rayshobby/opensprinkler-beagle/hardware/osbo_v10_diagram.jpg

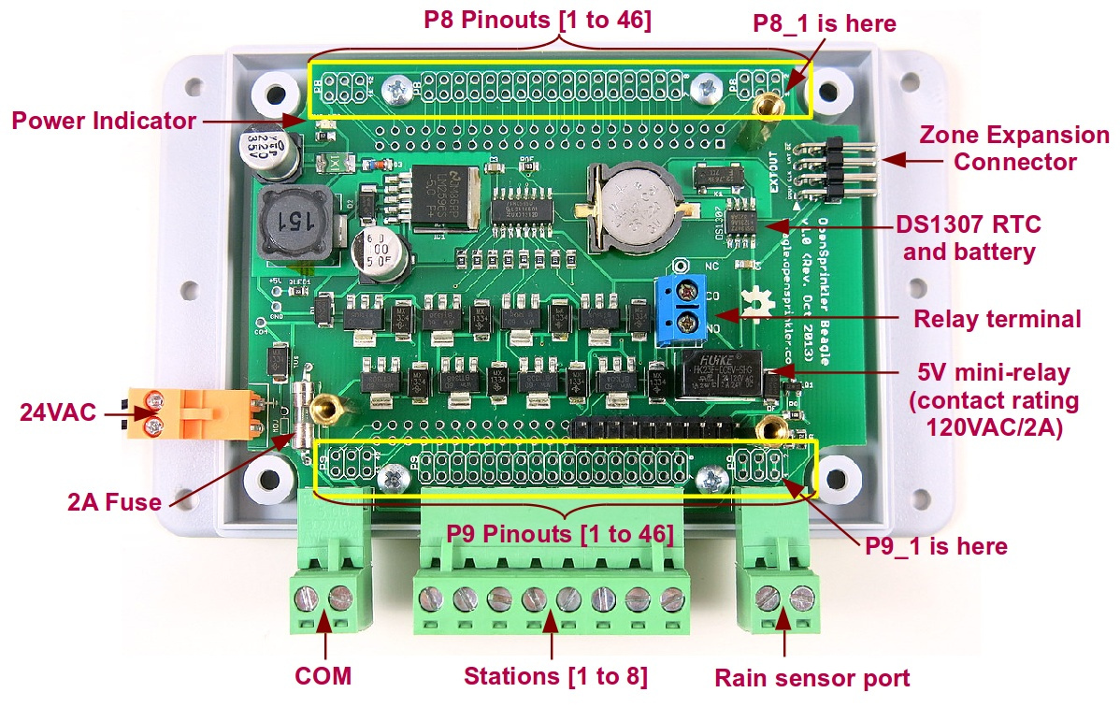
hardware/osbo_v10_diagram.jpg
