rayshobby/opensprinkler-beagle/README.md

opensprinkler-beagle
====================

OpenSprinkler Beagle (http://beagle.opensprinkler.com)
