rayshobby/opensprinkler-beagle/hardware/README.txt

OpenSprinkler Beagle (OSBo) Eagle Design Files
==========================================
Note: requires Eagle CAD v6.0 or above

Part lists of all versions can be found at:
http://xxx

Release Notes
=============
Version 1.1
---------------------
- Changed to use OpenSprinkler injection-molded enclosure
- Changed relay to HK4100F-5V

Initial Release v1.0
---------------------
- LM2596S-5.0 switching regulator.
- DS1307 RTC with CR1220 backup battery.
- Shift register, BT1308W triac solenoid driver.
- SMBJ48CA bidirectional TVS.
- 5V mini-relay (contact rating 120VAC/2A).
- 2A solder-on fuse.
