rayshobby/opensprinkler-beagle/hardware/osbo_v10_sch.png

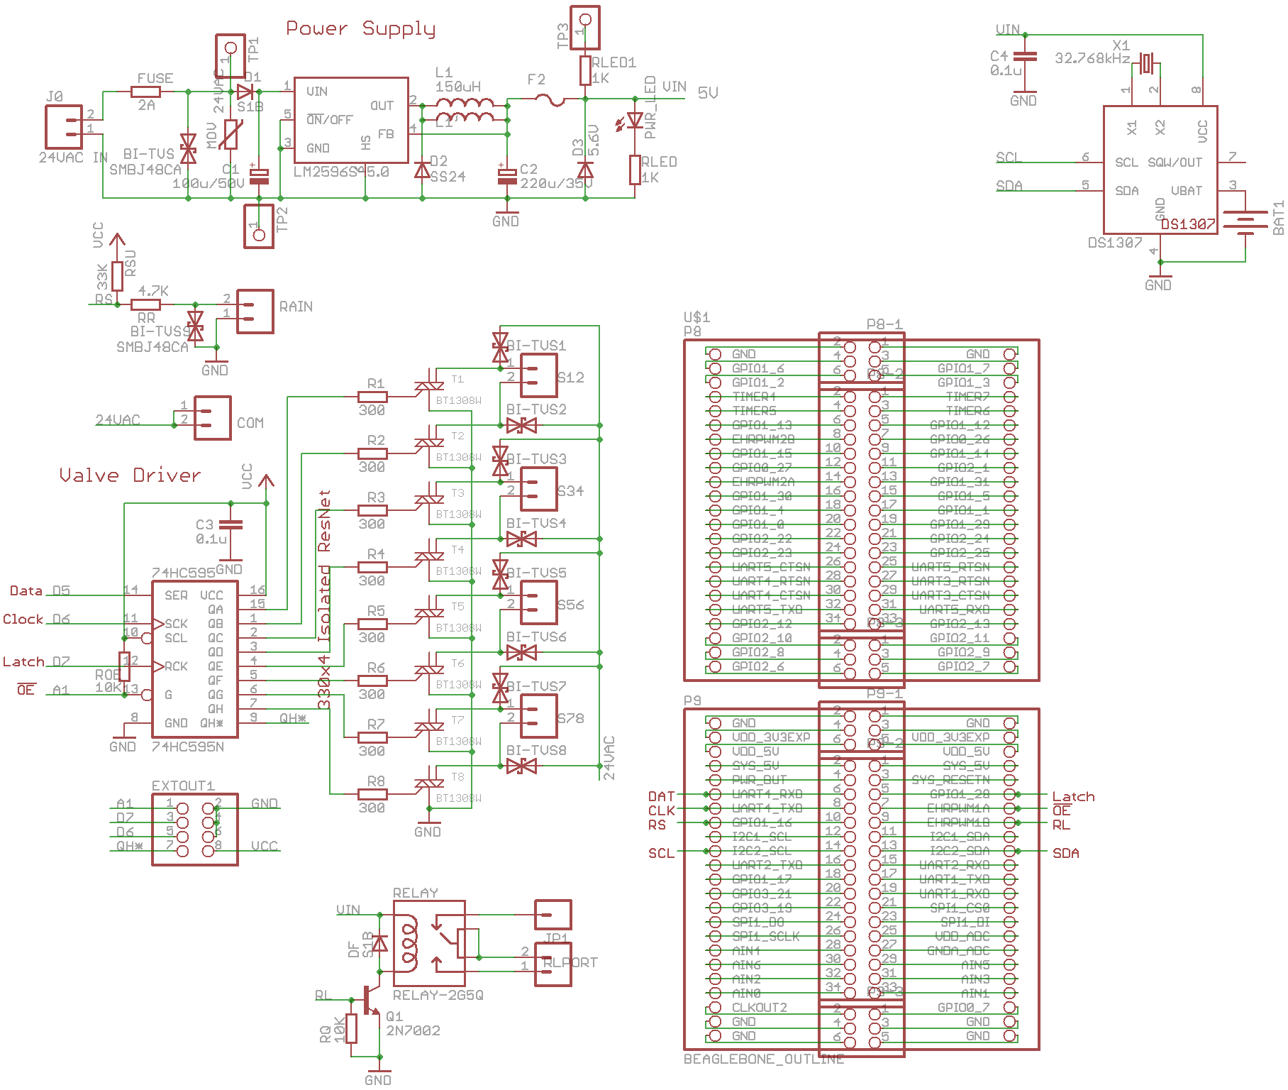
hardware/osbo_v10_sch.png
