rayshobby/opensprinkler-beagle/hardware/osbo_v11_sch.png

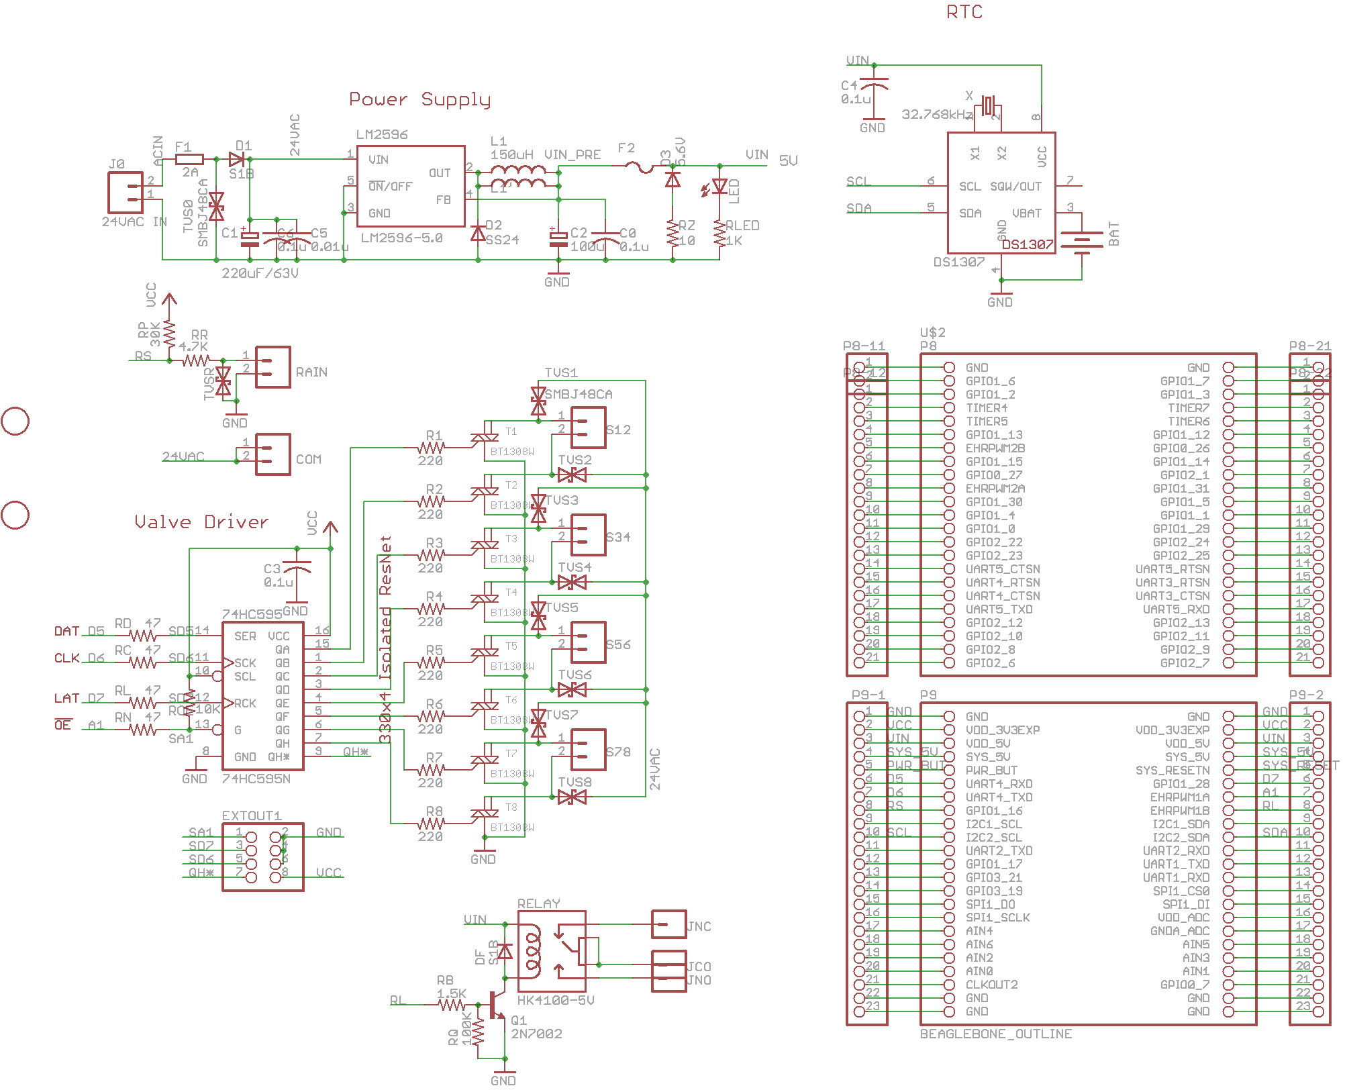
hardware/osbo_v11_sch.png
