rayshobby/opensprinkler-beagle/hardware/osbo_v11.brd

## EAGLE design hardware/osbo_v11.brd (2015-04-25)

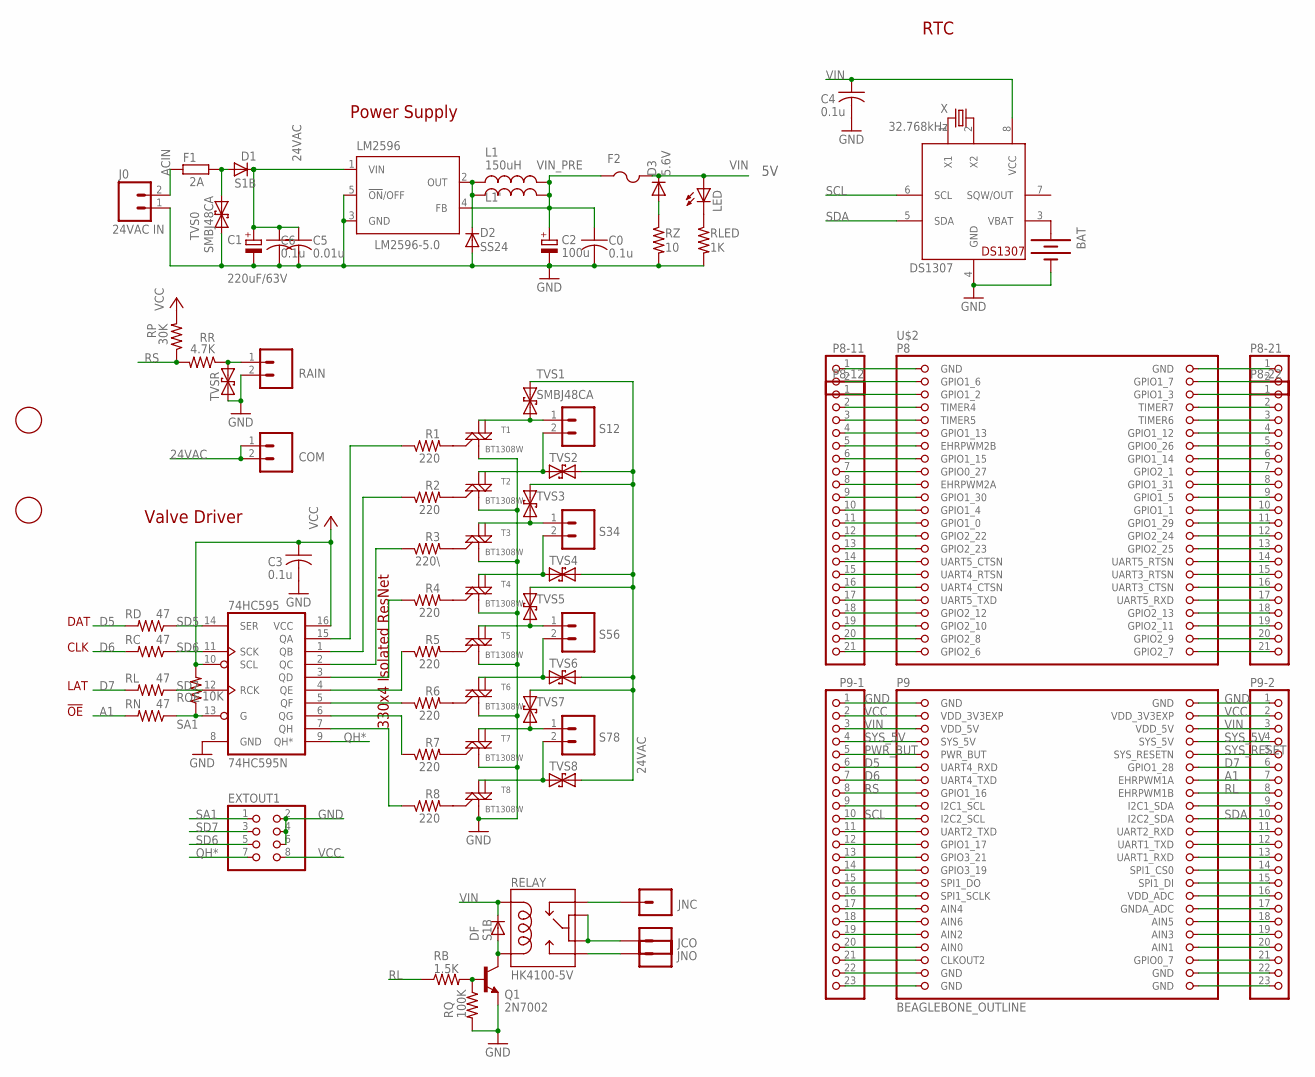
[picture p5: schematic osbo_v11.sch]

Parts:
74HC595: 74HC595N; SO16
BAT: BATTERYBATTERY_12MM_SMT; BATTCON_12MM_SMT
C0, C3, C4, C6: 0.1u; C0805K
C1: 220uF/63V; E5-10.5-1
C2: 100u; E3,5-8
C5: 0.01u; C0805K
COM: M025MM-X; SCREWTERMINAL-5MM-2-X
D1: S1B; DO-214AC
D2: SS24; SMB
D3: 5.6V; MINIMELF
DF: S1B; DO-214AC
DS1307: DS1307; SO08
EXTOUT1: PINHD-2X4/90; 2X04/90
F1: 2A; 0411V
F2: PTCFUSE-1812; 1812
J0: 24VAC IN; SCREWTERMINAL-4MM-2-X
JCO: M01PTH; 1X01
JNC: M01PTH; 1X01
JNO: M01PTH; 1X01
L1: 150uH; CDRH125
L1': 150uH; 0207/7
LED: LEDCHIPLED_0805; CHIPLED_0805
LM2596: LM2596-5.0; TO263-5
P8-11, P8-21: PINHD-1X2; 1X02
P8-12, P8-22: PINHD-1X21; 1X21
P9-1, P9-2: PINHD-1X23; 1X23
Q1: 2N7002; SOT23-3
R1, R2, R4, R5, R6, R7, R8: 220; R0805
R3: 220\; R0805
RAIN: M025MM-X; SCREWTERMINAL-5MM-2-X
RB: 1.5K; R0805
RC: 47; R0805
RD: 47; R0805
RELAY: HK4100-5V; RELAY-HK4100F
RL: 47; R0805
RLED: 1K; R0805
RN: 47; R0805
ROE: 10K; R0805
RP: 30K; R0805
RQ: 100K; R0805
RR: 4.7K; R0805
RZ: 10; R0805
S12, S34, S56, S78: M025MM-X; SCREWTERMINAL-5MM-2-X
T1, T2, T3, T4, T5, T6, T7, T8: BT1308W; SOT223
TVS0, TVS1: SMBJ48CA; SMB
TVS2, TVS3, TVS4, TVS5, TVS6, TVS7, TVS8: TVSSMB; SMB
TVSR: TVSSMB; SMB
U$1, U$3: FIDUCIAL; FIDUCIAL_1MM
U$2: BEAGLEBONE_OUTLINE; BEAGLEBONE_SHIELD
X: 32.768kHz; TC38H

Connections:
24VAC: COM.1, COM.2, D1.A, F1.2, TVS0.C, TVS1.C, TVS2.C, TVS3.C, TVS4.C, TVS5.C, TVS6.C, TVS7.C, TVS8.C
A1: P9-2.7, RN.2, U$2.60 (EHRPWM1A)
ACIN: F1.1, J0.2
CO: JCO.1, RELAY.5, RELAY.6
D5: P9-1.6, RD.2, U$2.57 (UART4_RXD)
D6: P9-1.7, RC.2, U$2.59 (UART4_TXD)
D7: P9-2.6, RL.2, U$2.58 (GPIO1_28)
GND: 74HC595.8 (GND), BAT.P$1 (-), C0.2, C1.-, C2.-, C3.2, C4.2, C5.2, C6.2, D2.A, DS1307.4 (GND), EXTOUT1.2, EXTOUT1.4, EXTOUT1.6, J0.1, LM2596.3 (GND), LM2596.5 (!ON!/OFF), P8-11.1, P8-21.1, P9-1.1, P9-2.1, Q1.2 (E), RAIN.2, RLED.2, RQ.2, RZ.2, T1.1 (M1), T2.1 (M1), T3.1 (M1), T4.1 (M1), T5.1 (M1), T6.1 (M1), T7.1 (M1), T8.1 (M1), TVS0.A, TVSR.A, U$2.1 (GND), U$2.2 (GND), U$2.47 (GND), U$2.48 (GND)
unnamed: LED.C, RLED.1
unnamed: C1.+, C5.1, C6.1, D1.C, LM2596.1 (VIN)
unnamed: R1.2, T1.3 (G)
unnamed: 74HC595.5 (QF), R6.1
unnamed: 74HC595.6 (QG), R7.1
unnamed: D3.A, RZ.1
unnamed: 74HC595.7 (QH), R8.1
unnamed: D2.C, L1.1, L1'.1, LM2596.2 (OUT)
unnamed: DS1307.1 (X1), X.2
unnamed: 74HC595.4 (QE), R5.1
unnamed: 74HC595.3 (QD), R4.1
unnamed: 74HC595.2 (QC), R3.1
unnamed: 74HC595.1 (QB), R2.1
unnamed: 74HC595.15 (QA), R1.1
unnamed: R2.2, T2.3 (G)
unnamed: S12.1, T1.2 (M2), TVS1.A
unnamed: S12.2, T2.2 (M2), TVS2.A
unnamed: S34.1, T3.2 (M2), TVS3.A
unnamed: R3.2, T3.3 (G)
unnamed: S34.2, T4.2 (M2), TVS4.A
unnamed: R4.2, T4.3 (G)
unnamed: S56.1, T5.2 (M2), TVS5.A
unnamed: S56.2, T6.2 (M2), TVS6.A
unnamed: S78.1, T7.2 (M2), TVS7.A
unnamed: S78.2, T8.2 (M2), TVS8.A
unnamed: R5.2, T5.3 (G)
unnamed: R6.2, T6.3 (G)
unnamed: R7.2, T7.3 (G)
unnamed: R8.2, T8.3 (G)
unnamed: DS1307.2 (X2), X.1
unnamed: RAIN.1, RR.1, TVSR.C
unnamed: Q1.1 (B), RB.2, RQ.1
unnamed: P8-11.2, U$2.3 (GPIO1_6)
unnamed: P8-12.1, U$2.5 (GPIO1_2)
unnamed: BAT.P$2 (+), DS1307.3 (VBAT)
unnamed: P8-12.2, U$2.7 (TIMER4)
unnamed: P8-12.3, U$2.9 (TIMER5)
unnamed: P8-12.4, U$2.11 (GPIO1_13)
unnamed: P8-12.5, U$2.13 (EHRPWM2B)
unnamed: P8-12.6, U$2.15 (GPIO1_15)
unnamed: P8-12.7, U$2.17 (GPIO0_27)
unnamed: P8-12.8, U$2.19 (EHRPWM2A)
unnamed: P8-12.9, U$2.21 (GPIO1_30)
unnamed: P8-12.10, U$2.23 (GPIO1_4)
unnamed: P8-12.11, U$2.25 (GPIO1_0)
unnamed: P8-12.12, U$2.27 (GPIO2_22)
unnamed: P8-12.13, U$2.29 (GPIO2_23)
unnamed: P8-12.14, U$2.31 (UART5_CTSN)
unnamed: P8-12.15, U$2.33 (UART4_RTSN)
unnamed: P8-12.16, U$2.35 (UART4_CTSN)
unnamed: P8-12.17, U$2.37 (UART5_TXD)
unnamed: P8-12.18, U$2.39 (GPIO2_12)
unnamed: P8-12.19, U$2.41 (GPIO2_10)
unnamed: P8-12.20, U$2.43 (GPIO2_8)
unnamed: P8-12.21, U$2.45 (GPIO2_6)
unnamed: P8-21.2, U$2.4 (GPIO1_7)
unnamed: P8-22.1, U$2.6 (GPIO1_3)
unnamed: P8-22.2, U$2.8 (TIMER7)
unnamed: P8-22.3, U$2.10 (TIMER6)
unnamed: P8-22.4, U$2.12 (GPIO1_12)
unnamed: P8-22.5, U$2.14 (GPIO0_26)
unnamed: P8-22.6, U$2.16 (GPIO1_14)
unnamed: P8-22.7, U$2.18 (GPIO2_1)
unnamed: P8-22.8, U$2.20 (GPIO1_31)
unnamed: P8-22.9, U$2.22 (GPIO1_5)
unnamed: P8-22.10, U$2.24 (GPIO1_1)
unnamed: P8-22.11, U$2.26 (GPIO1_29)
unnamed: P8-22.12, U$2.28 (GPIO2_24)
unnamed: P8-22.13, U$2.30 (GPIO2_25)
unnamed: P8-22.14, U$2.32 (UART5_RTSN)
unnamed: P8-22.15, U$2.34 (UART3_RTSN)
unnamed: P8-22.16, U$2.36 (UART3_CTSN)
unnamed: P8-22.17, U$2.38 (UART5_RXD)
unnamed: P8-22.18, U$2.40 (GPIO2_13)
unnamed: DF.A, Q1.3 (C), RELAY.9
unnamed: P8-22.19, U$2.42 (GPIO2_11)
unnamed: P8-22.20, U$2.44 (GPIO2_9)
unnamed: P8-22.21, U$2.46 (GPIO2_7)
unnamed: P9-1.9, U$2.63 (I2C1_SCL)
unnamed: P9-1.11, U$2.67 (UART2_TXD)
unnamed: P9-1.12, U$2.69 (GPIO1_17)
unnamed: P9-1.13, U$2.71 (GPIO3_21)
unnamed: P9-1.14, U$2.73 (GPIO3_19)
unnamed: P9-1.15, U$2.75 (SPI1_DO)
unnamed: P9-1.16, U$2.77 (SPI1_SCLK)
unnamed: P9-1.17, U$2.79 (AIN4)
unnamed: P9-1.18, U$2.81 (AIN6)
unnamed: P9-1.19, U$2.83 (AIN2)
unnamed: P9-1.20, U$2.85 (AIN0)
unnamed: P9-1.21, U$2.87 (CLKOUT2)
unnamed: P9-1.22, U$2.89 (GND)
unnamed: P9-1.23, U$2.91 (GND)
unnamed: P9-2.9, U$2.64 (I2C1_SDA)
unnamed: P9-2.11, U$2.68 (UART2_RXD)
unnamed: P9-2.12, U$2.70 (UART1_TXD)
unnamed: P9-2.13, U$2.72 (UART1_RXD)
unnamed: P9-2.14, U$2.74 (SPI1_CS0)
unnamed: P9-2.15, U$2.76 (SPI1_DI)
unnamed: P9-2.16, U$2.78 (VDD_ADC)
unnamed: P9-2.17, U$2.80 (GNDA_ADC)
unnamed: P9-2.18, U$2.82 (AIN5)
unnamed: P9-2.19, U$2.84 (AIN3)
unnamed: P9-2.20, U$2.86 (AIN1)
unnamed: P9-2.21, U$2.88 (GPIO0_7)
unnamed: P9-2.22, U$2.90 (GND)
unnamed: P9-2.23, U$2.92 (GND)
NC: JNC.1, RELAY.1
NO: JNO.1, RELAY.10
PWR_BUT: P9-1.5, U$2.55 (PWR_BUT)
QH*: 74HC595.9 (QH*), EXTOUT1.7
RL: P9-2.8, RB.1, U$2.62 (EHRPWM1B)
RS: P9-1.8, RP.1, RR.2, U$2.61 (GPIO1_16)
SA1: 74HC595.13 (G), EXTOUT1.1, RN.1, ROE.1
SCL: DS1307.6 (SCL), P9-1.10, U$2.65 (I2C2_SCL)
SD5: 74HC595.14 (SER), RD.1
SD6: 74HC595.11 (SCK), EXTOUT1.5, RC.1
SD7: 74HC595.12 (RCK), EXTOUT1.3, RL.1
SDA: DS1307.5 (SDA), P9-2.10, U$2.66 (I2C2_SDA)
SYS_5V: P9-1.4, P9-2.4, U$2.53 (SYS_5V), U$2.54 (SYS_5V)
SYS_RESET: P9-2.5, U$2.56 (SYS_RESETN)
VCC: 74HC595.10 (SCL), 74HC595.16 (VCC), C3.1, EXTOUT1.8, P9-1.2, P9-2.2, ROE.2, RP.2, U$2.49 (VDD_3V3EXP), U$2.50 (VDD_3V3EXP)
VIN: C4.1, D3.C, DF.C, DS1307.8 (VCC), F2.2, LED.A, P9-1.3, P9-2.3, RELAY.2, U$2.51 (VDD_5V), U$2.52 (VDD_5V)
VIN_PRE: C0.1, C2.+, F2.1, L1.2, L1'.2, LM2596.4 (FB)

Notes on the sheet:
Power Supply
Valve Driver
DAT
CLK
LAT
330x4 Isolated ResNet
!OE
RTC

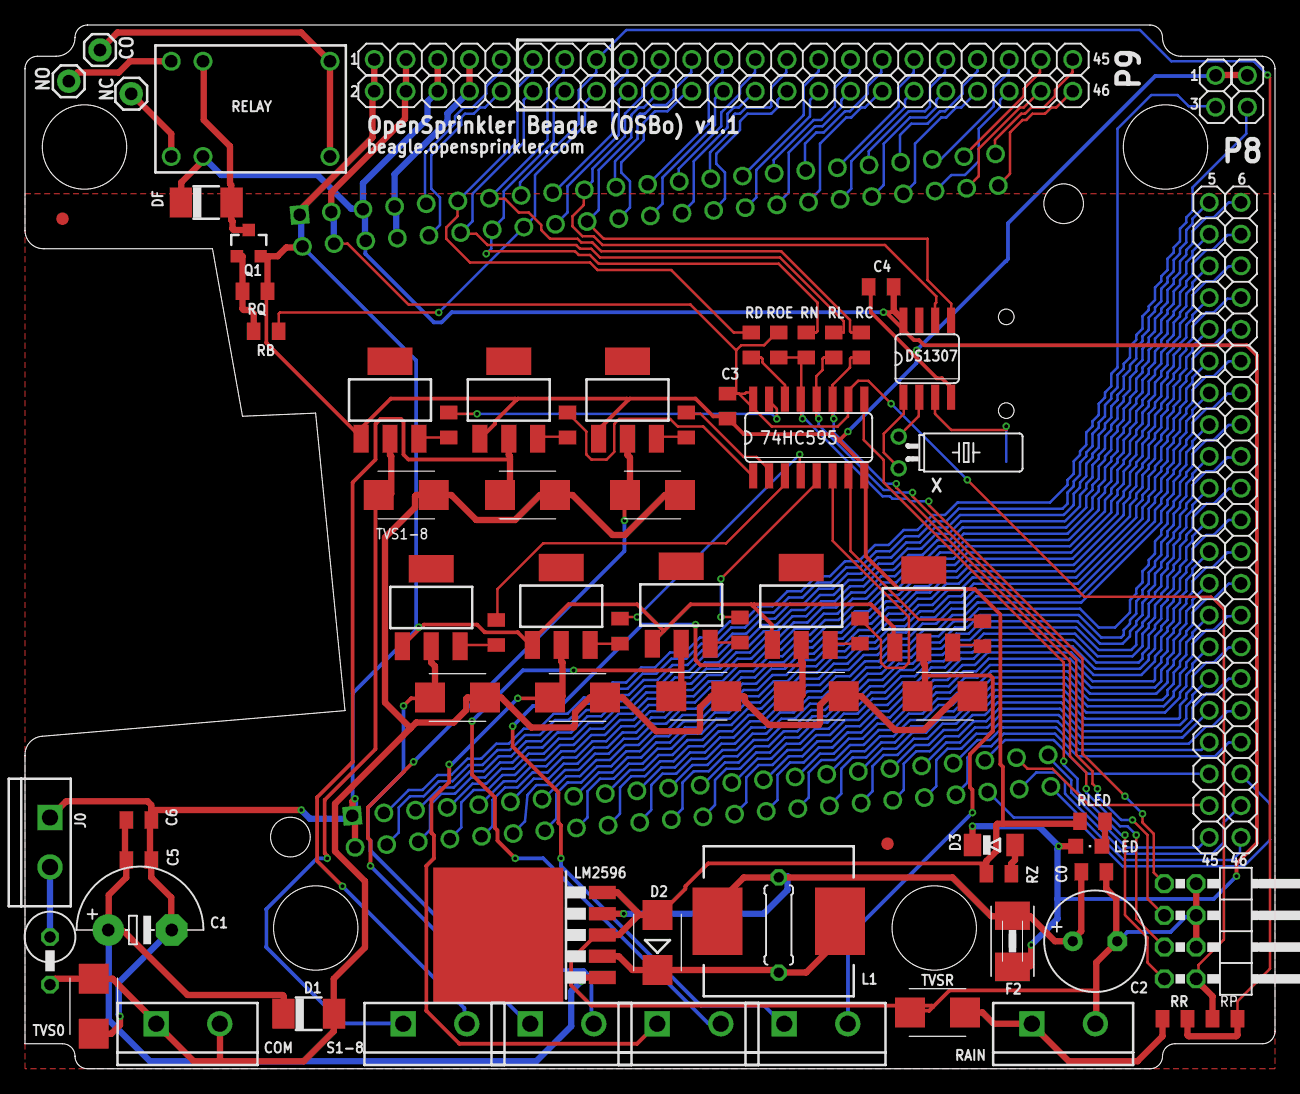
[picture p6: board osbo_v11.brd from above]

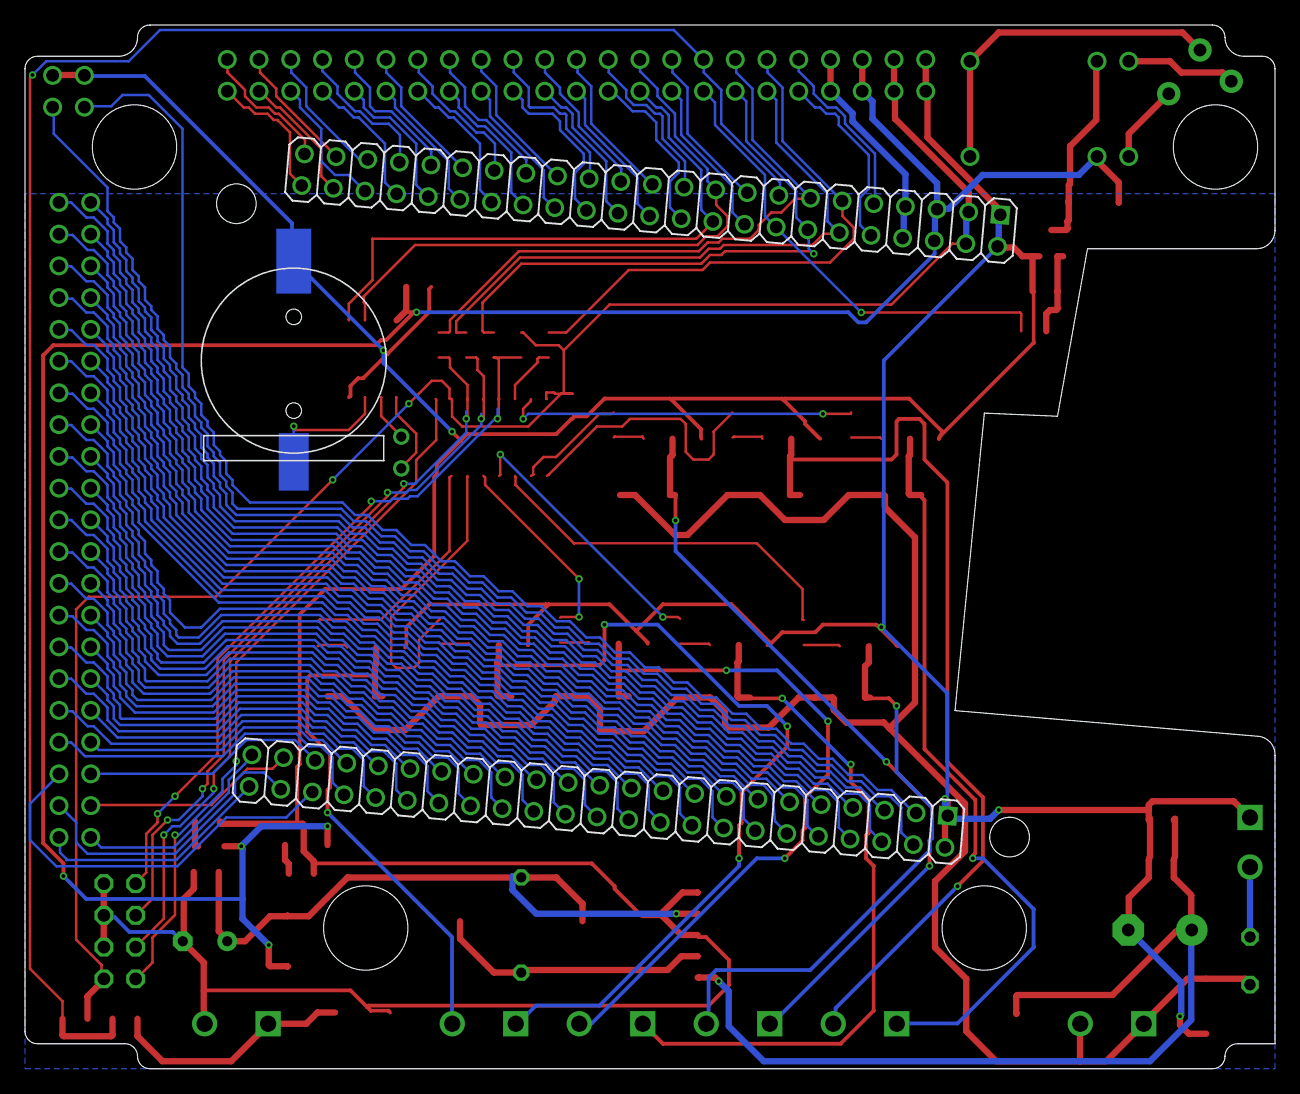
[picture p7: board osbo_v11.brd from below]

Board: 2 copper layers, 100.0 x 83.5 mm, 80 parts (2 on the bottom side), 131 nets.
