rayshobby/opensprinkler-beagle/hardware/osbo_v10.brd

## EAGLE design hardware/osbo_v10.brd (2013-11-13, an earlier design)

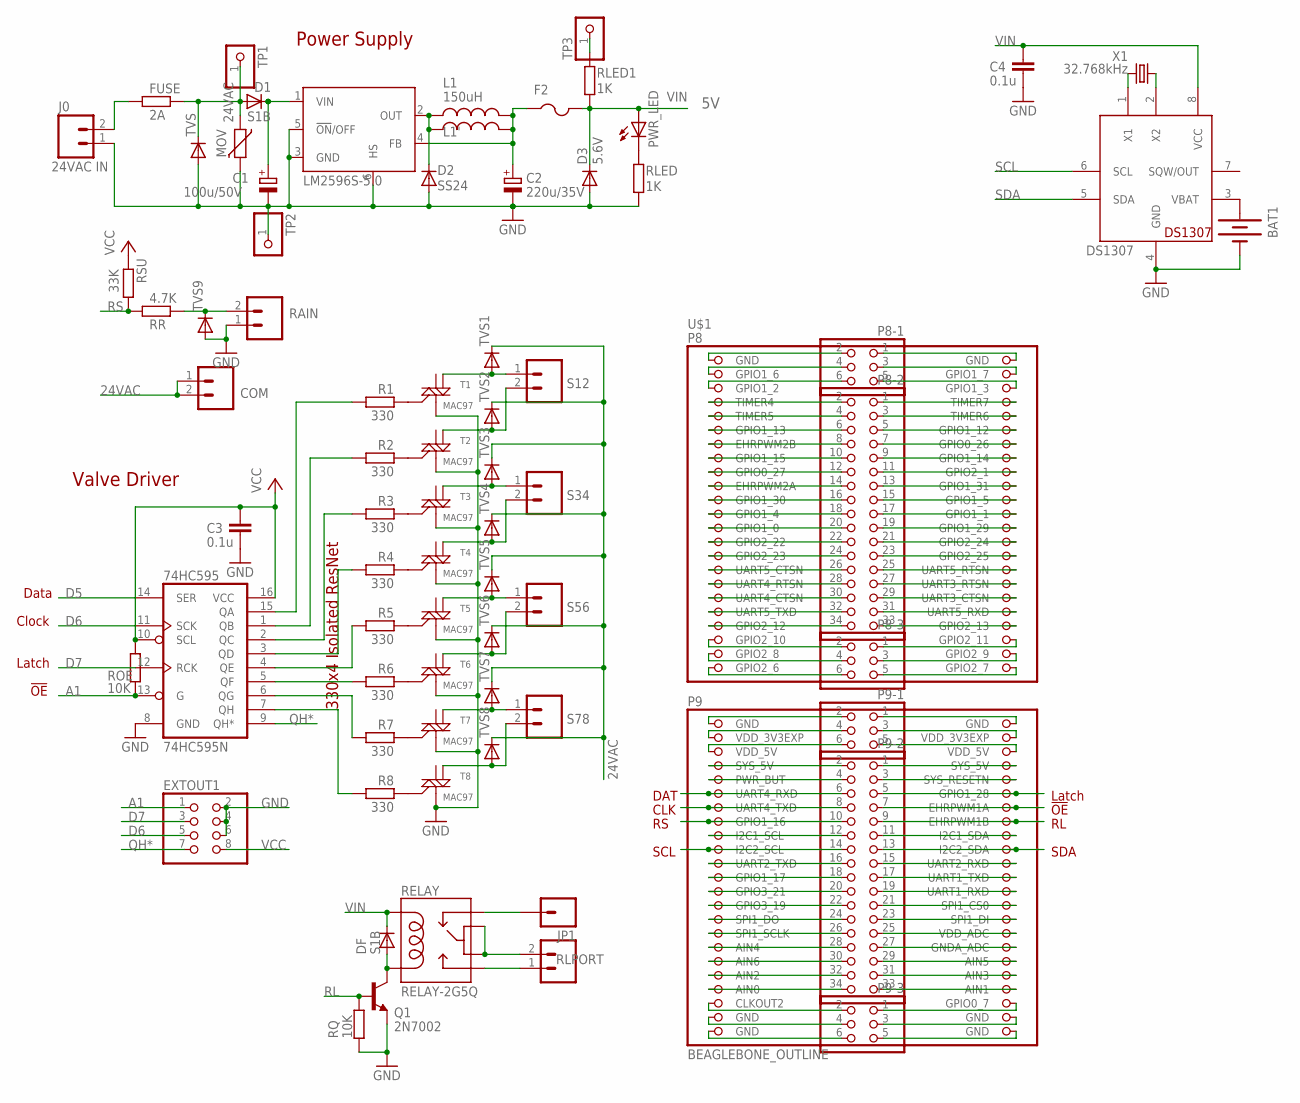
[picture p8: schematic osbo_v10.sch]

Parts:
74HC595: 74HC595N; SO16
BAT1: BATTERYBATTERY_12MM_SMT; BATTCON_12MM_SMT
C1: 100u/50V; PANASONIC_E
C2: 220u/35V; PANASONIC_E
C3, C4: 0.1u; C0805
COM: M025MM-X; SCREWTERMINAL-5MM-2-X
D1: S1B; DO-214AC
D2: SS24; SMB
D3: 5.6V; MINIMELF
DF: S1B; DO-214AC
DS1307: DS1307; SO08
EXTOUT1: PINHD-2X4/90; 2X04/90
F2: PTCFUSE-1812; 1812
FUSE: 2A; 0411/15
IC1: LM2596S-5.0; TO263-5
J0: 24VAC IN; SCREWTERMINAL-4MM-2-X
JP1: M01PTH; 1X01
L1: 150uH; CDRH125
L1': 150uH; 0207/7
MOV: VARISTOR-5; R-5
P8-1, P8-3, P9-1, P9-3: PINHD-2X3; 2X03
P8-2, P9-2: PINHD-2X17; 2X17
PWR_LED: LEDCHIPLED_0805; CHIPLED_0805
Q1: 2N7002; SOT23-3
R1, R2, R3, R4, R5, R6, R7, R8: 330; R0805
RAIN: M025MM-X; SCREWTERMINAL-5MM-2-X
RELAY: RELAY-2G5Q; RELAY-G5V
RLED, RLED1: 1K; R0805
RLPORT: M025MM; SCREWTERMINAL-5MM-2
ROE: 10K; R0805
RQ: 10K; R0805
RR: 4.7K; R0805
RSU: 33K; R0805
S12, S34, S56, S78: M025MM-X; SCREWTERMINAL-5MM-2-X
T1, T2, T3, T4, T5, T6, T7, T8: MAC97; SOT223
TP1, TP2, TP3: PINHD-1X1CB; 1X01-CLEANBIG
TVS, TVS1, TVS2, TVS3, TVS4, TVS5, TVS6, TVS7, TVS8, TVS9: DIODE-SMB; SMB
U$1: BEAGLEBONE_OUTLINE; BEAGLEBONE_SHIELD
X1: 32.768kHz; MM20SS

Connections:
24VAC: COM.1, COM.2, D1.A, FUSE.2, MOV.1, TP1.1, TVS.C, TVS1.C, TVS2.C, TVS3.C, TVS4.C, TVS5.C, TVS6.C, TVS7.C, TVS8.C
A1: 74HC595.13 (G), EXTOUT1.1, P9-2.7, ROE.1, U$1.60 (EHRPWM1A)
ACIN: FUSE.1, J0.2
CO: RELAY.5, RELAY.6, RLPORT.2
D5: 74HC595.14 (SER), P9-2.6, U$1.57 (UART4_RXD)
D6: 74HC595.11 (SCK), EXTOUT1.5, P9-2.8, U$1.59 (UART4_TXD)
D7: 74HC595.12 (RCK), EXTOUT1.3, P9-2.5, U$1.58 (GPIO1_28)
G5: R5.2, T5.3 (G)
GND: 74HC595.8 (GND), BAT1.P$1 (-), C1.-, C2.-, C3.2, C4.2, D2.A, D3.A, DS1307.4 (GND), EXTOUT1.2, EXTOUT1.4, EXTOUT1.6, IC1.3 (GND), IC1.5 (!ON!/OFF), IC1.6 (HS), J0.1, MOV.2, P9-1.1, P9-1.2, Q1.2 (E), RAIN.1, RLED.2, RQ.2, T1.1 (M1), T2.1 (M1), T3.1 (M1), T4.1 (M1), T5.1 (M1), T6.1 (M1), T7.1 (M1), T8.1 (M1), TP2.1, TVS.A, TVS9.A, U$1.47 (GND), U$1.48 (GND)
I2C1_SCL: P9-2.12, U$1.63 (I2C1_SCL)
I2C1_SDA: P9-2.11, U$1.64 (I2C1_SDA)
unnamed: PWR_LED.C, RLED.1
unnamed: C1.+, D1.C, IC1.1 (VIN)
unnamed: R1.2, T1.3 (G)
unnamed: 74HC595.5 (QF), R6.1
unnamed: 74HC595.6 (QG), R7.1
unnamed: BAT1.P$2 (+), DS1307.3 (VBAT)
unnamed: 74HC595.7 (QH), R8.1
unnamed: D2.C, IC1.2 (OUT), L1.1, L1'.1
unnamed: P8-1.2, U$1.1 (GND)
unnamed: 74HC595.4 (QE), R5.1
unnamed: 74HC595.3 (QD), R4.1
unnamed: 74HC595.2 (QC), R3.1
unnamed: 74HC595.1 (QB), R2.1
unnamed: 74HC595.15 (QA), R1.1
unnamed: R2.2, T2.3 (G)
unnamed: S12.1, T1.4 (M2-4), TVS1.A
unnamed: S12.2, T2.4 (M2-4), TVS2.A
unnamed: S34.1, T3.4 (M2-4), TVS3.A
unnamed: R3.2, T3.3 (G)
unnamed: S34.2, T4.4 (M2-4), TVS4.A
unnamed: R4.2, T4.3 (G)
unnamed: S56.1, T5.4 (M2-4), TVS5.A
unnamed: S56.2, T6.4 (M2-4), TVS6.A
unnamed: S78.1, T7.4 (M2-4), TVS7.A
unnamed: S78.2, T8.4 (M2-4), TVS8.A
unnamed: RAIN.2, RR.1, TVS9.C
unnamed: R6.2, T6.3 (G)
unnamed: R7.2, T7.3 (G)
unnamed: R8.2, T8.3 (G)
unnamed: P8-1.1, U$1.2 (GND)
unnamed: DS1307.1 (X1), X1.1
unnamed: P8-1.4, U$1.3 (GPIO1_6)
unnamed: P8-1.3, U$1.4 (GPIO1_7)
unnamed: P8-1.6, U$1.5 (GPIO1_2)
unnamed: P8-1.5, U$1.6 (GPIO1_3)
unnamed: P8-3.6, U$1.45 (GPIO2_6)
unnamed: P8-3.5, U$1.46 (GPIO2_7)
unnamed: P8-3.4, U$1.43 (GPIO2_8)
unnamed: P8-3.2, U$1.41 (GPIO2_10)
unnamed: P8-3.3, U$1.44 (GPIO2_9)
unnamed: P8-3.1, U$1.42 (GPIO2_11)
unnamed: P8-2.2, U$1.7 (TIMER4)
unnamed: P8-2.4, U$1.9 (TIMER5)
unnamed: P8-2.6, U$1.11 (GPIO1_13)
unnamed: P8-2.8, U$1.13 (EHRPWM2B)
unnamed: P8-2.10, U$1.15 (GPIO1_15)
unnamed: P8-2.12, U$1.17 (GPIO0_27)
unnamed: P8-2.14, U$1.19 (EHRPWM2A)
unnamed: P8-2.16, U$1.21 (GPIO1_30)
unnamed: P8-2.18, U$1.23 (GPIO1_4)
unnamed: P8-2.20, U$1.25 (GPIO1_0)
unnamed: P8-2.22, U$1.27 (GPIO2_22)
unnamed: P8-2.24, U$1.29 (GPIO2_23)
unnamed: P8-2.26, U$1.31 (UART5_CTSN)
unnamed: P8-2.28, U$1.33 (UART4_RTSN)
unnamed: P8-2.30, U$1.35 (UART4_CTSN)
unnamed: P8-2.32, U$1.37 (UART5_TXD)
unnamed: P8-2.34, U$1.39 (GPIO2_12)
unnamed: P8-2.1, U$1.8 (TIMER7)
unnamed: P8-2.3, U$1.10 (TIMER6)
unnamed: P8-2.5, U$1.12 (GPIO1_12)
unnamed: P8-2.7, U$1.14 (GPIO0_26)
unnamed: P8-2.9, U$1.16 (GPIO1_14)
unnamed: P8-2.11, U$1.18 (GPIO2_1)
unnamed: P8-2.13, U$1.20 (GPIO1_31)
unnamed: P8-2.15, U$1.22 (GPIO1_5)
unnamed: P8-2.17, U$1.24 (GPIO1_1)
unnamed: P8-2.19, U$1.26 (GPIO1_29)
unnamed: P8-2.21, U$1.28 (GPIO2_24)
unnamed: P8-2.23, U$1.30 (GPIO2_25)
unnamed: P8-2.25, U$1.32 (UART5_RTSN)
unnamed: P8-2.27, U$1.34 (UART3_RTSN)
unnamed: P8-2.29, U$1.36 (UART3_CTSN)
unnamed: P8-2.31, U$1.38 (UART5_RXD)
unnamed: P8-2.33, U$1.40 (GPIO2_13)
unnamed: DS1307.2 (X2), X1.4 (2)
unnamed: DF.A, Q1.3 (C), RELAY.9
unnamed: RLED1.1, TP3.1
unnamed: P9-3.6, U$1.91 (GND)
unnamed: P9-3.4, U$1.89 (GND)
unnamed: P9-3.2, U$1.87 (CLKOUT2)
unnamed: P9-3.5, U$1.92 (GND)
unnamed: P9-3.3, U$1.90 (GND)
unnamed: P9-3.1, U$1.88 (GPIO0_7)
unnamed: P9-2.15, U$1.68 (UART2_RXD)
unnamed: P9-2.17, U$1.70 (UART1_TXD)
unnamed: P9-2.19, U$1.72 (UART1_RXD)
unnamed: P9-2.21, U$1.74 (SPI1_CS0)
unnamed: P9-2.23, U$1.76 (SPI1_DI)
unnamed: P9-2.25, U$1.78 (VDD_ADC)
unnamed: P9-2.27, U$1.80 (GNDA_ADC)
unnamed: P9-2.29, U$1.82 (AIN5)
unnamed: P9-2.31, U$1.84 (AIN3)
unnamed: P9-2.33, U$1.86 (AIN1)
unnamed: P9-2.16, U$1.67 (UART2_TXD)
unnamed: P9-2.18, U$1.69 (GPIO1_17)
unnamed: P9-2.20, U$1.71 (GPIO3_21)
unnamed: P9-2.22, U$1.73 (GPIO3_19)
unnamed: P9-2.24, U$1.75 (SPI1_DO)
unnamed: P9-2.26, U$1.77 (SPI1_SCLK)
unnamed: P9-2.28, U$1.79 (AIN4)
unnamed: P9-2.30, U$1.81 (AIN6)
unnamed: P9-2.32, U$1.83 (AIN2)
unnamed: P9-2.34, U$1.85 (AIN0)
NC: JP1.1, RELAY.1
NO: RELAY.10, RLPORT.1
PWR_BUT: P9-2.4, U$1.55 (PWR_BUT)
QH*: 74HC595.9 (QH*), EXTOUT1.7
RL: P9-2.9, Q1.1 (B), RQ.1, U$1.62 (EHRPWM1B)
RS: P9-2.10, RR.2, RSU.1, U$1.61 (GPIO1_16)
SCL: DS1307.6 (SCL), P9-2.14, U$1.65 (I2C2_SCL)
SDA: DS1307.5 (SDA), P9-2.13, U$1.66 (I2C2_SDA)
SYS_5V: P9-2.1, P9-2.2, U$1.53 (SYS_5V), U$1.54 (SYS_5V)
SYS_RESET: P9-2.3, U$1.56 (SYS_RESETN)
VCC: 74HC595.10 (SCL), 74HC595.16 (VCC), C3.1, EXTOUT1.8, P9-1.3, P9-1.4, ROE.2, RSU.2, U$1.49 (VDD_3V3EXP), U$1.50 (VDD_3V3EXP)
VIN: C4.1, D3.C, DF.C, DS1307.8 (VCC), F2.2, P9-1.5, P9-1.6, PWR_LED.A, RELAY.2, RLED1.2, U$1.51 (VDD_5V), U$1.52 (VDD_5V)
VIN_PRE: C2.+, F2.1, IC1.4 (FB), L1.2, L1'.2

Notes on the sheet:
Power Supply
Valve Driver
Data
Clock
Latch
330x4 Isolated ResNet
!OE
DAT
CLK
SCL
SDA

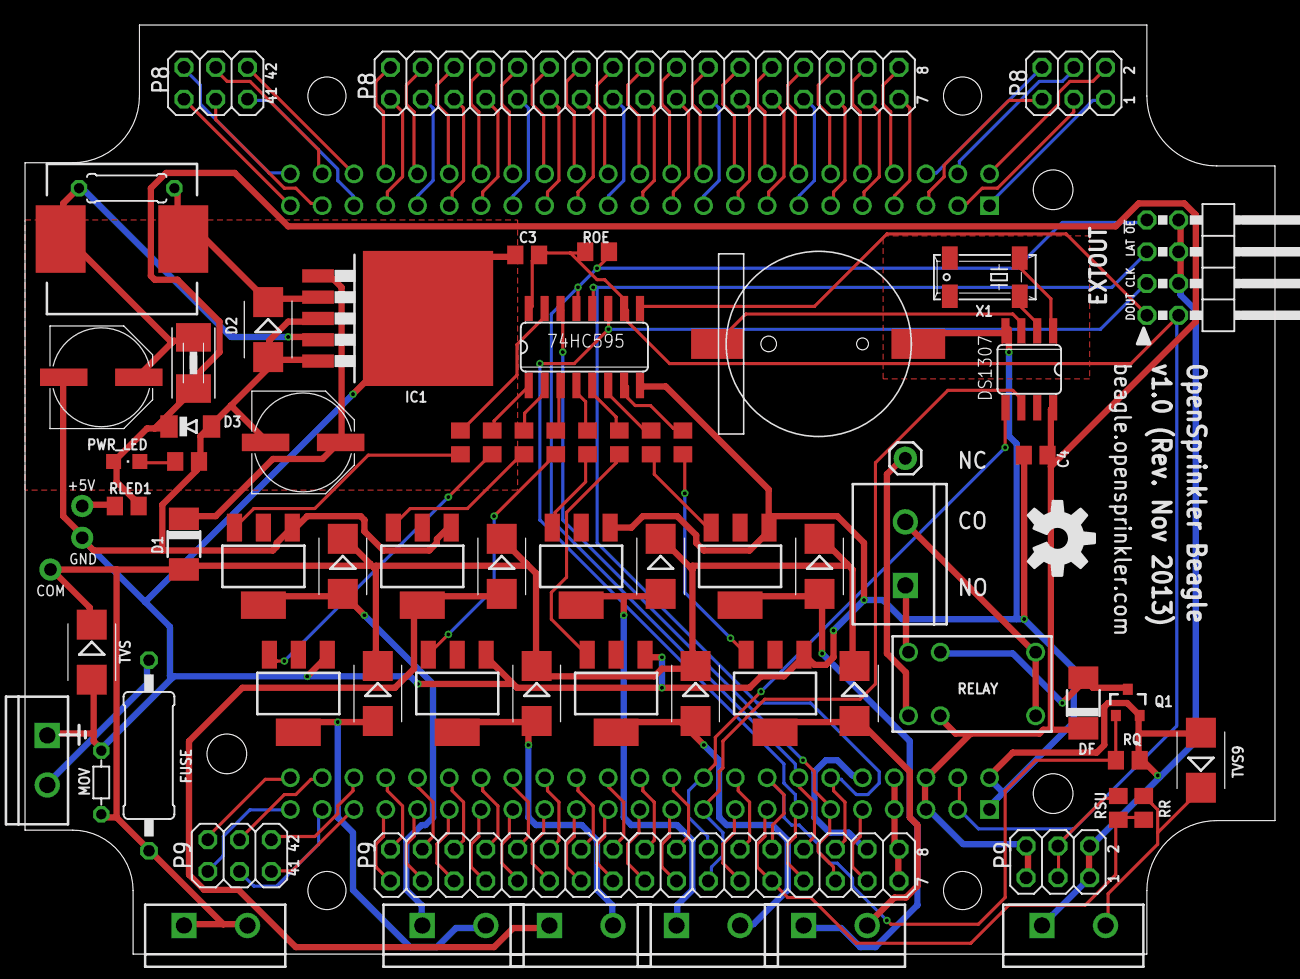
[picture p9: board osbo_v10.brd from above]

Board: 2 copper layers, 99.9 x 74.3 mm, 73 parts (1 on the bottom side), 128 nets.
