rayshobby/opensprinkler-beagle/(commit log)

2013-11-13 initial checkin of osbo 1.0 hardware files
    [osbo_v10.brd, osbo_v10.sch]
2013-11-13 minor change to the board design
    [osbo_v10.brd]
2013-11-14 check in OSBo v1.0 BOM
2013-11-24 fix bidirectional tvs symbol in the schematic.
2015-04-25 check in OSBo 1.1 Eagle files
    [osbo_v11.brd, osbo_v11.sch]
